Zapfenkiller/potiscan/Joystick_TWI_Projekt/Joystick_TWI_Schematics/PCstick_brd.pdf

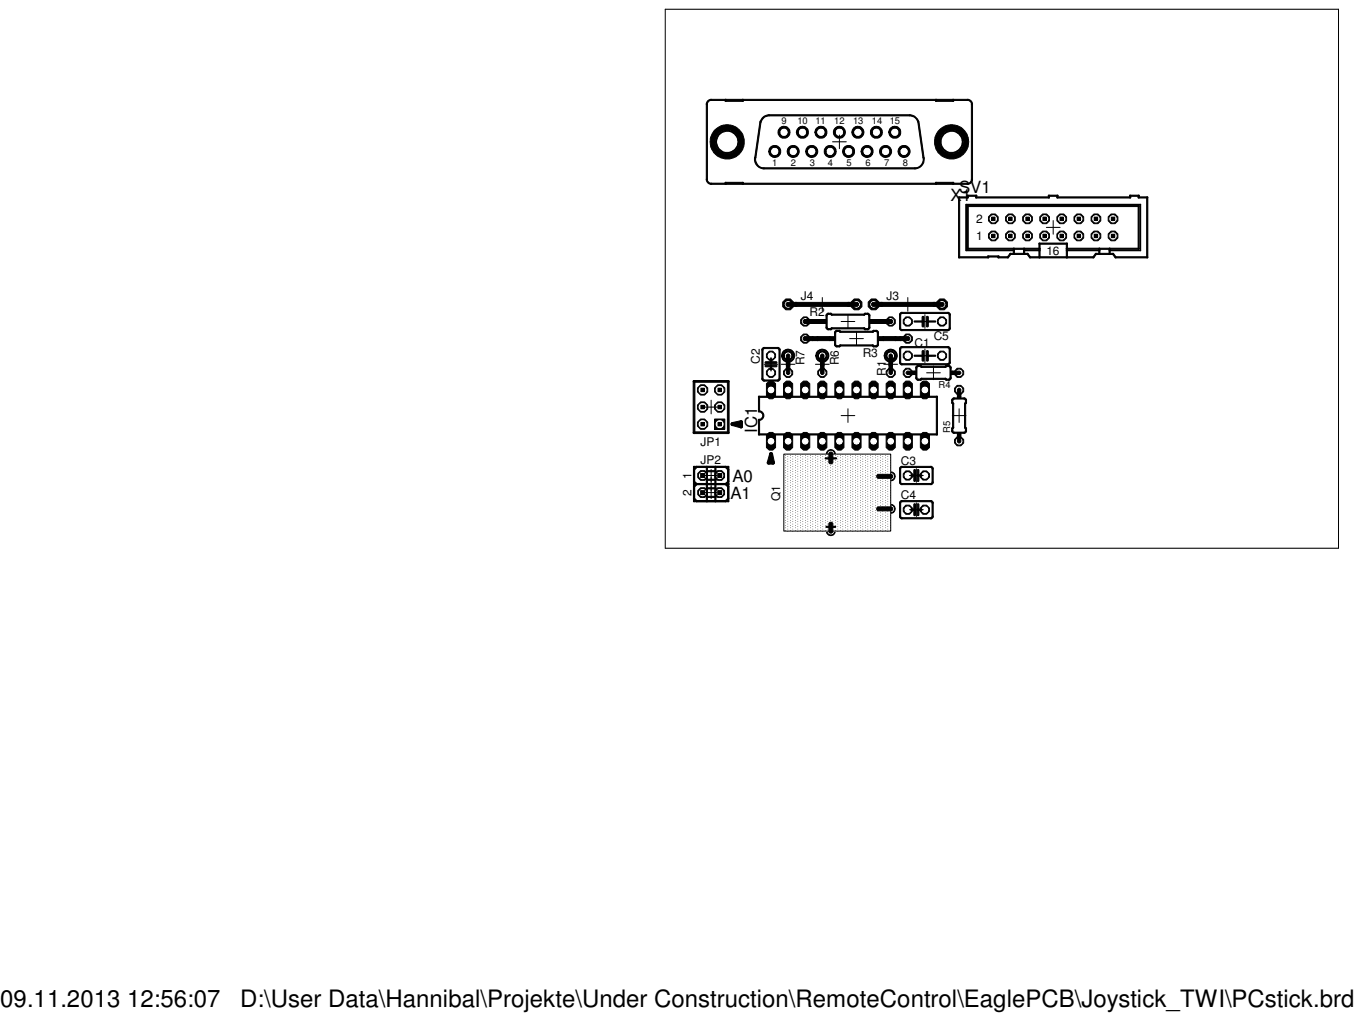
[picture p11: page 1]

09.11.2013 12:56:07 D:\User Data\Hannibal\Projekte\Under Construction\RemoteControl\EaglePCB\Joystick_TWI\PCstick.brd
