Zapfenkiller/potiscan/Joystick_TWI_Projekt/Joystick_TWI_Schematics/PCstick_layout_lötseite.pdf

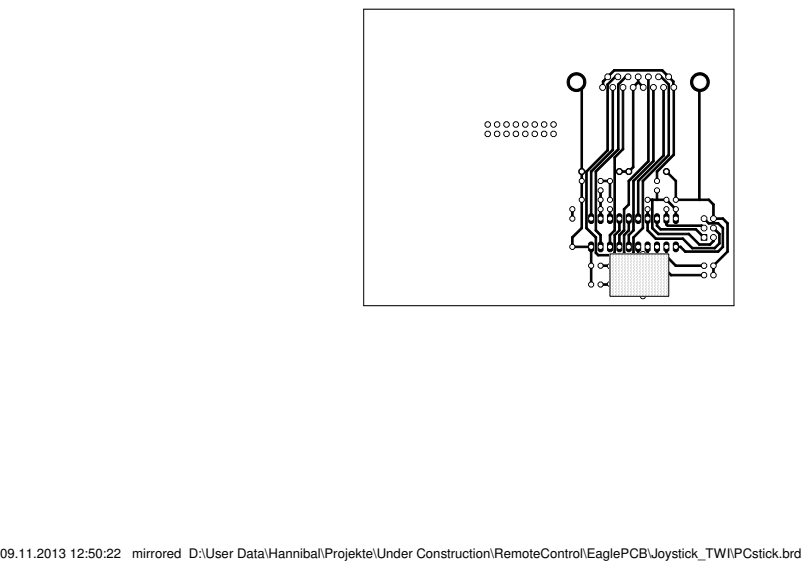
[picture p12: page 1]

09.11.2013 12:50:22 mirrored D:\User Data\Hannibal\Projekte\Under Construction\RemoteControl\EaglePCB\Joystick_TWI\PCstick.brd
