Zapfenkiller/potiscan/Joystick_TWI_Projekt/Joystick_TWI_Schematics/PCstick_sch.pdf

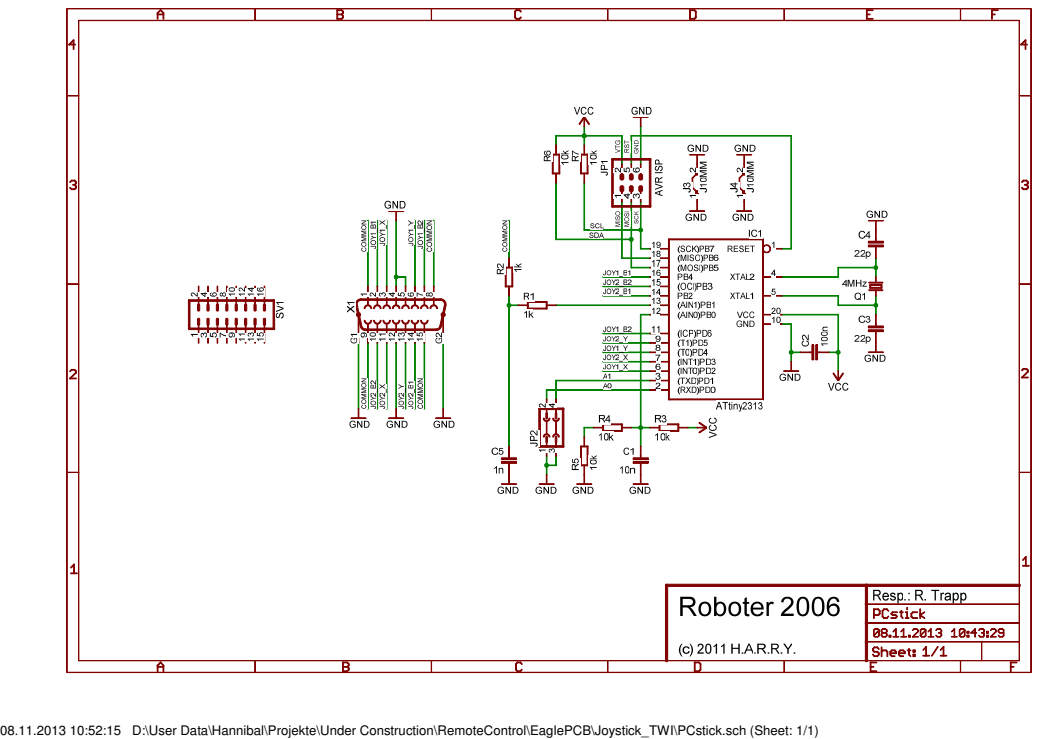
[picture p13: page 1]

08.11.2013 10:52:15 D:\User Data\Hannibal\Projekte\Under Construction\RemoteControl\EaglePCB\Joystick_TWI\PCstick.sch (Sheet: 1/1)
